SrijanCherupally/Rocket-Airbrakes/SCH_HexaFlight V3_2025-06-21.pdf

# HexaFlight V2

POWER INPUT SELECTION | 5V to 3.3V | POWER LED | USER LED

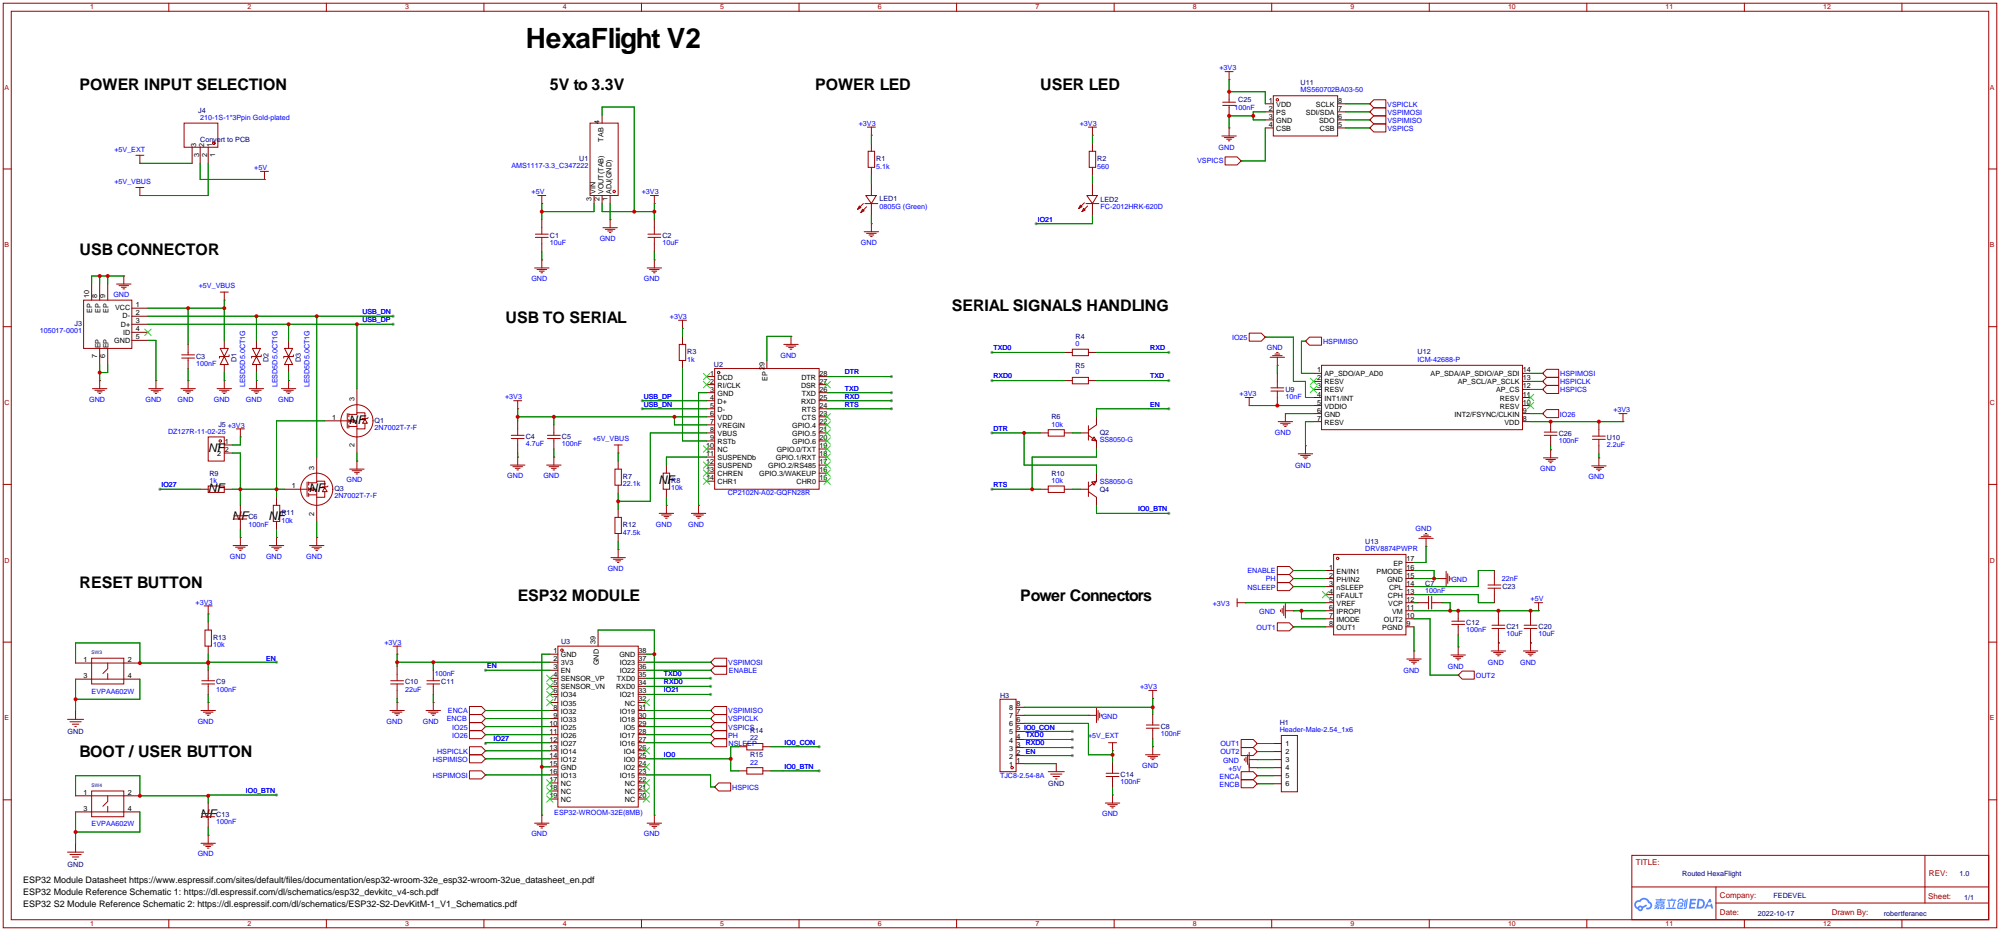
[picture p1: page 1]

ESP32 Module Datasheet https://www.espressif.com/sites/default/files/documentation/esp32-wroom-32e_esp32-wroom-32ue_datasheet_en.pdf
ESP32 Module Reference Schematic 1: https://dl.espressif.com/dl/schematics/esp32_devkitc_v4-sch.pdf
ESP32 S2 Module Reference Schematic 2: https://dl.espressif.com/dl/schematics/ESP32-S2-DevKitM-1_V1_Schematics.pdf
