SrijanCherupally/Rocket-Airbrakes/(list of files, drawings)

Other design files:
Rocket PCB Final.epro
